morysmh/KeyBoard/(list of files, drawings)

Other design files:
PCB/Split-Keyboard-V3-36keys/SK-Additional_keys.SchDoc
PCB/Split-Keyboard-V3-36keys/SK-Connector.SchDoc
PCB/Split-Keyboard-V3-36keys/SK-keys.SchDoc
PCB/Split-Keyboard-V3-36keys/SK-PiCo.SchDoc
PCB/Split-Keyboard-V3-36keys/Split-Keyboard-V3-36keys.PrjPcb
