morysmh/KeyBoard/Code/LayerKeyboard.c

#include "define.h"
#include "keyboard.h"
#include "PC_keyboard.h"

volatile uint16_t Layer1[Keys_Count*2+1][2] = 
{
{HID_KEY_T,0},
{HID_KEY_R,0},
{HID_KEY_E,0},
{HID_KEY_W,0},
{HID_KEY_Q,0},
{HID_KEY_G,0},
{HID_KEY_F,HID_KEY_SHIFT_LEFT},
{HID_KEY_D,HID_KEY_CONTROL_LEFT},
{HID_KEY_S,HID_KEY_ALT_LEFT},
{HID_KEY_A,HID_KEY_GUI_LEFT},
{HID_KEY_B,0},
{HID_KEY_V,0},
{HID_KEY_C,0},
{HID_KEY_X,0},
{HID_KEY_Z,0},
{HID_KEY_TAB,0},
{HID_KEY_SPACE,Software_Press_Layer2},
{HID_KEY_ESCAPE,0},
{HID_KEY_Y,Software_Layer4},
{HID_KEY_U,HID_KEY_SHIFT_LEFT},
{HID_KEY_I,HID_KEY_CONTROL_RIGHT},
{HID_KEY_O,HID_KEY_ALT_LEFT},
{HID_KEY_P,HID_KEY_GUI_LEFT},
{HID_KEY_H,0},
{HID_KEY_J,0},
{HID_KEY_K,0},
{HID_KEY_L,0},
{HID_KEY_SEMICOLON,0},
{HID_KEY_N,0},
{HID_KEY_M,0},
{HID_KEY_COMMA,0},
{HID_KEY_PERIOD,0},
{HID_KEY_SLASH,0},
{HID_KEY_ENTER,Software_Press_Layer3},
{HID_KEY_BACKSPACE,0},
};
volatile uint16_t Layer2[Keys_Count*2+1][2] = 
{
{HID_KEY_EQUAL,0},
{HID_KEY_MINUS,0},
{HID_KEY_E,0},
{HID_KEY_ARROW_UP,0},
{HID_KEY_TAB,0},
{HID_KEY_BACKSLASH,0},
{HID_KEY_KEYPAD_MULTIPLY,0},
{HID_KEY_ARROW_RIGHT,0},
{HID_KEY_ARROW_DOWN,0},
{HID_KEY_ARROW_LEFT,0},
{HID_KEY_B,0},
{HID_KEY_V,0},
{HID_KEY_C,0},
{HID_KEY_GUI_LEFT,0},
{HID_KEY_Z,0},
{HID_KEY_TAB,0},
{HID_KEY_SPACE,Software_Layer1},
{HID_KEY_ESCAPE,0},
{HID_KEY_KEYPAD_MULTIPLY,0},
{HID_KEY_KEYPAD_7,0},
{HID_KEY_KEYPAD_8,0},
{HID_KEY_KEYPAD_9,0},
{HID_KEY_KEYPAD_SUBTRACT,0},
{HID_KEY_KEYPAD_DIVIDE,0},
{HID_KEY_KEYPAD_4,0},
{HID_KEY_KEYPAD_5,0},
{HID_KEY_KEYPAD_6,0},
{HID_KEY_KEYPAD_ADD,0},
{HID_KEY_KEYPAD_0,0},
{HID_KEY_KEYPAD_1,0},
{HID_KEY_KEYPAD_2,0},
{HID_KEY_KEYPAD_3,0},
{HID_KEY_KEYPAD_DECIMAL,0},
{HID_KEY_ENTER,0},
{HID_KEY_BACKSPACE,0},
{HID_KEY_DELETE,0},
};
volatile uint16_t Layer3[Keys_Count*2+1][2] = 
{
{HID_KEY_BRACKET_RIGHT,0},
{HID_KEY_9,0},
{HID_KEY_8,0},
{HID_KEY_7,0},
{HID_KEY_BRACKET_LEFT,0},
{HID_KEY_EQUAL,0},
{HID_KEY_6,0},
{HID_KEY_5,0},
{HID_KEY_4,0},
{HID_KEY_GRAVE,0},
{HID_KEY_BACKSLASH,0},
{HID_KEY_3,0},
{HID_KEY_2,0},
{HID_KEY_1,0},
{HID_KEY_APOSTROPHE,0},
{HID_KEY_MINUS,0},
{HID_KEY_0,Software_Layer1},
{HID_KEY_PERIOD,0},
{0,0},
{HID_KEY_SHIFT_LEFT,0},
{HID_KEY_CONTROL_RIGHT,0},
{HID_KEY_ALT_LEFT,0},
{HID_KEY_GUI_LEFT,0},
{0,0},
{0,0},
{0,0},
{0,0},
{0,0},
{0,0},
{0,0},
{0,0},
{0,0},
{0,0},
{0,0},
{0,0},
};

volatile uint16_t Layer4[Keys_Count*2+1][2] = 
{
{HID_KEY_F12,0},
{HID_KEY_F9,0},
{HID_KEY_F8,0},
{HID_KEY_F7,0},
{HID_KEY_F12,0},
{HID_KEY_F11,0},
{HID_KEY_F6,0},
{HID_KEY_F5,0},
{HID_KEY_F4,0},
{HID_KEY_GRAVE,0},
{HID_KEY_BACKSLASH,0},
{HID_KEY_F3,0},
{HID_KEY_F2,0},
{HID_KEY_F1,0},
{HID_KEY_APOSTROPHE,0},
{HID_KEY_MINUS,Software_Layer1},
{HID_KEY_F10,0},
{HID_KEY_ESCAPE,0},
{0,0},
{HID_KEY_SHIFT_LEFT,0},
{HID_KEY_CONTROL_RIGHT,0},
{HID_KEY_ALT_LEFT,0},
{HID_KEY_GUI_LEFT,0},
{0,0},
{0,0},
{0,0},
{0,0},
{0,0},
{0,0},
{0,0},
{0,0},
{0,0},
{0,0},
{0,0},
{0,0},
};
