morysmh/KeyBoard/(commit log)

2023-06-12 Added Code and PCB folder with PCB files
    [SK-Additional_keys.SchDoc, SK-Connector.SchDoc, SK-PiCo.SchDoc, SK-keys.SchDoc, Split-Keyboard-V3-36keys.PrjPcb]
2023-06-12 Added Schematic PDF to PCB documents
2023-10-23 Both hand work at this stage some debug need
2023-11-01 layer working and minur bug fixed
    [LayerKeyboard.c, PC_keyboard.c, define.h, keyboard.c, keyboard.h]
